VSangtani/crewline-roller-pcb/history/pcb-top.png

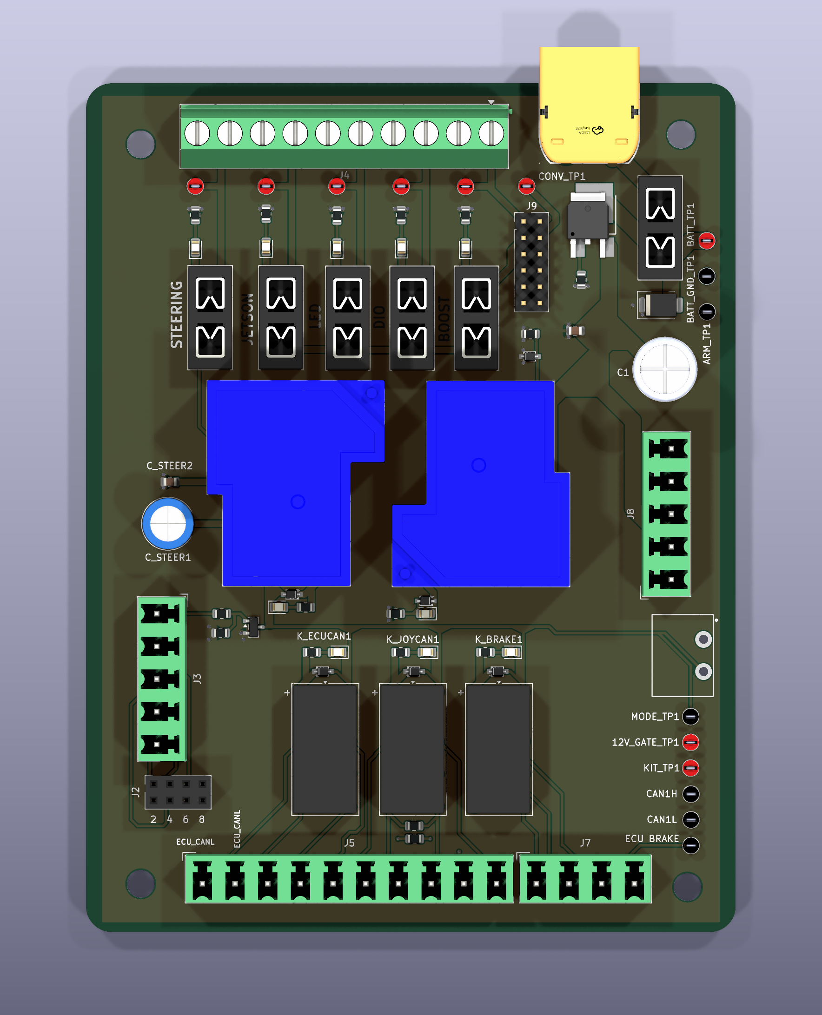
history/pcb-top.png
