VSangtani/crewline-roller-pcb/new/pcb-bottom.png

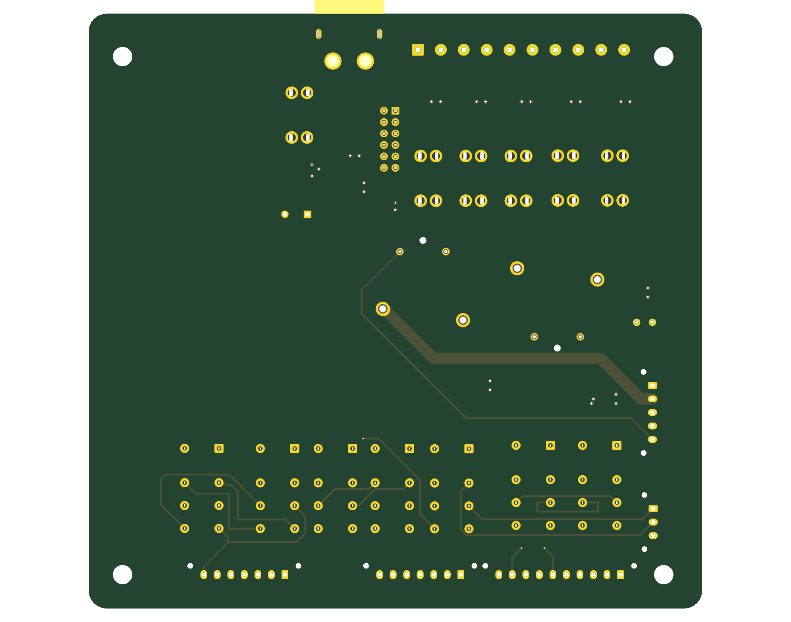
new/pcb-bottom.png
