VSangtani/crewline-roller-pcb/new/pcb-top.png

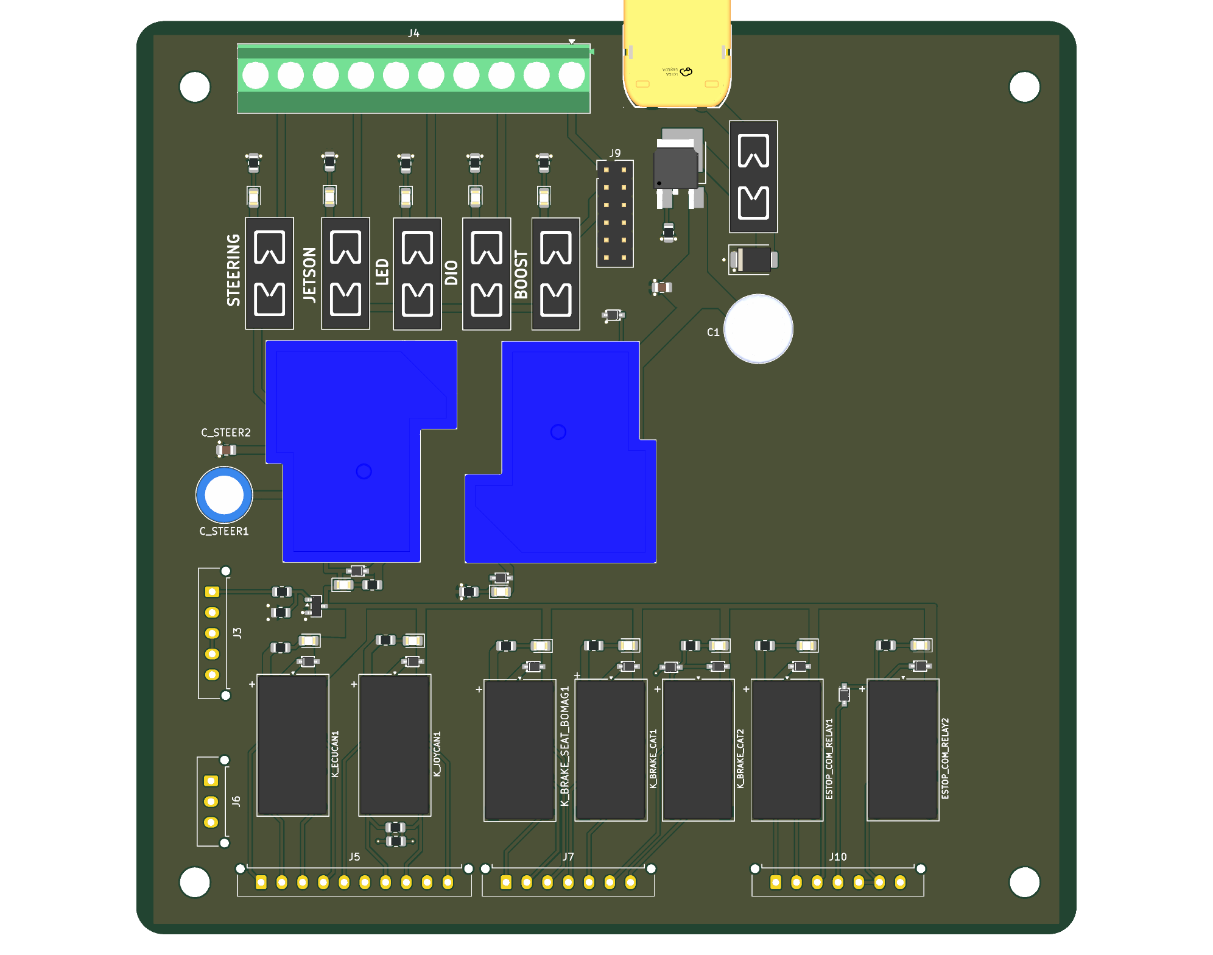
new/pcb-top.png
