VSangtani/crewline-roller-pcb/history/pcb.step

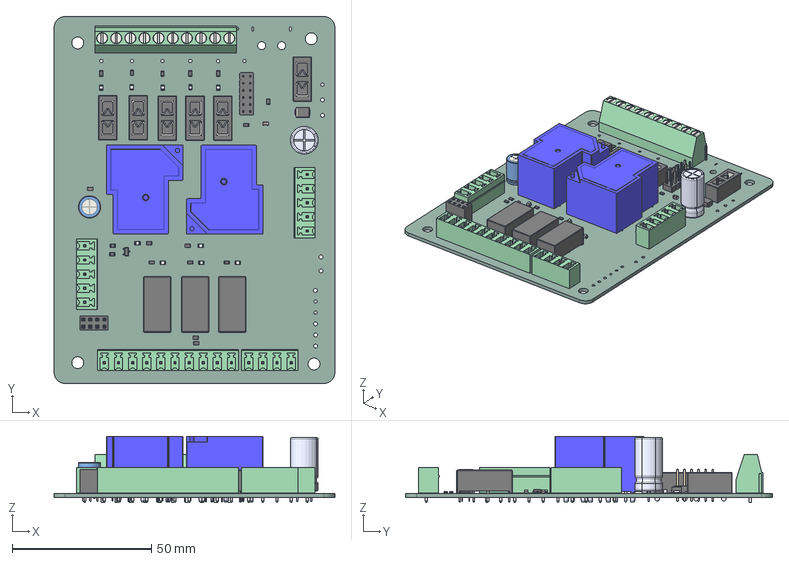
[picture p4: CAD file, 2026-09-28]
history/pcb.step
101.0 x 132.0 x 23.9 mm
PinSocket_2x04_P2.54mm_Vertical
TerminalBlock_Phoenix_MKDS-1,5-10-5.08_1x10_P5.08mm_Horizontal
R_0805_2012Metric x 16
LED_0805_2012Metric x 10
MCV_01x05_G_5_08mm x 2
A_Keystone_3568 x 6
PinHeader_2x06_P254mm_Vertical
SOT-23
MCV_01x04_G_5_08mm
SLA-12VDC-SL-C_SLA-12VDC-SL-C x 2
Relay_DPDT_Omron_G6A x 3
MCV_01x10_G_5_08mm
D_SMB
C_Radial_D80mm_H115mm_P350mm
C1_1000uF_leads_trimmed_to_3mm_for_assembly
C_0805_2012Metric x 2
CREWLINE-PRIM-PCB-001_PCB
