VSangtani/crewline-roller-pcb/new/pcb.step

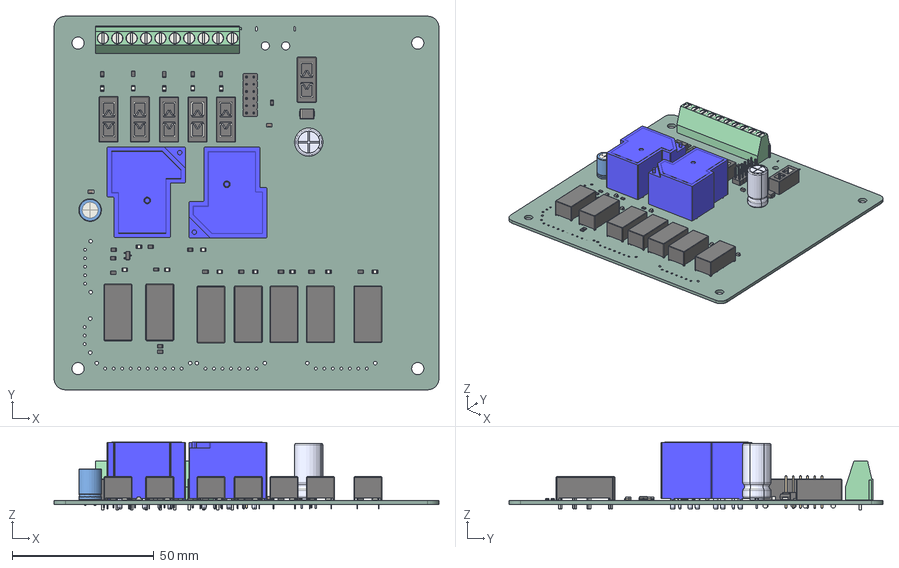
[picture p5: CAD file, 2026-10-01]
new/pcb.step
136.0 x 132.0 x 23.9 mm
LED_0805_2012Metric x 14
TerminalBlock_Phoenix_MKDS-1,5-10-5.08_1x10_P5.08mm_Horizontal
R_0805_2012Metric x 19
A_Keystone_3568 x 6
PinHeader_2x06_P254mm_Vertical
SOT-23
Relay_DPDT_Omron_G6A x 7
SLA-12VDC-SL-C_SLA-12VDC-SL-C x 2
D_SMB
C_Radial_D80mm_H115mm_P350mm
C1_1000uF_leads_trimmed_to_3mm_for_assembly
C_0805_2012Metric x 2
CREWLINE-PRIM-PCB-001_PCB
