VSangtani/crewline-roller-pcb/history/pcb_mated.step

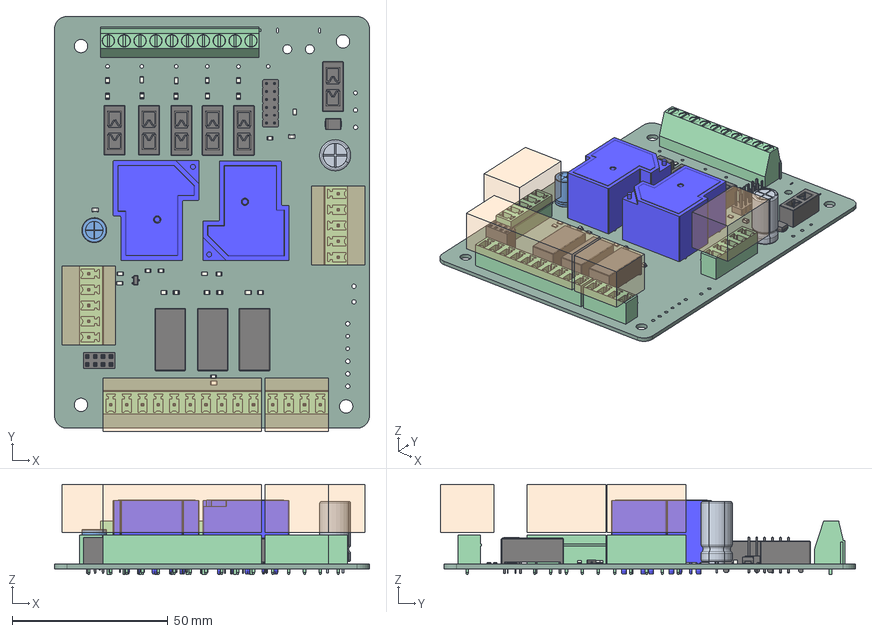
[picture p6: CAD file, 2026-09-28]
history/pcb_mated.step
101.0 x 133.1 x 29.0 mm
PinSocket_2x04_P2_54mm_Vertical
TerminalBlock_Phoenix_MKDS-1,5-10-5_08_1x10_P5_08mm_Horizontal
R_0805_2012Metric x 16
LED_0805_2012Metric x 10
MCV_01x05_G_5_08mm x 2
A_Keystone_3568 x 6
PinHeader_2x06_P254mm_Vertical
SOT-23
MCV_01x04_G_5_08mm
SLA-12VDC-SL-C_SLA-12VDC-SL-C x 2
Relay_DPDT_Omron_G6A x 3
MCV_01x10_G_5_08mm
D_SMB
C_Radial_D80mm_H115mm_P350mm
C1_1000uF_leads_trimmed_to_3mm_for_assembly
C_0805_2012Metric x 2
CREWLINE-PRIM-PCB-001_PCB
J3_plug_1836105_conservative_envelope
J5_plug_1836150_conservative_envelope
J7_plug_1836095_conservative_envelope
J8_plug_1836105_conservative_envelope
