VSangtani/crewline-roller-pcb/history/ABOUT.md

# Previous revision

These files describe the V3.1-H1 connector revision as it was before the brake and E-stop work.
They are kept for reference and are not maintained.

- `README.md` is that revision's own README.
- `original-design/` holds the three KiCad files and the footprint table exactly as they were
  in the first commit of this repository. Their 3D models are the ones in `../new/models/`.
- The reports, renders, scripts and STEP models are the outputs of that revision.

The live project is in `../new/`.
