VSangtani/crewline-roller-pcb/history/pcb-mated-check_20260925T151946Z.png

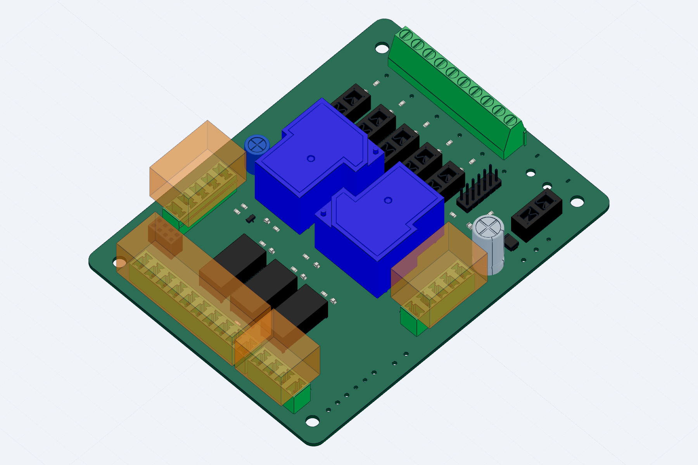
history/pcb-mated-check_20260925T151946Z.png
