VSangtani/crewline-roller-pcb/new/schematic.pdf

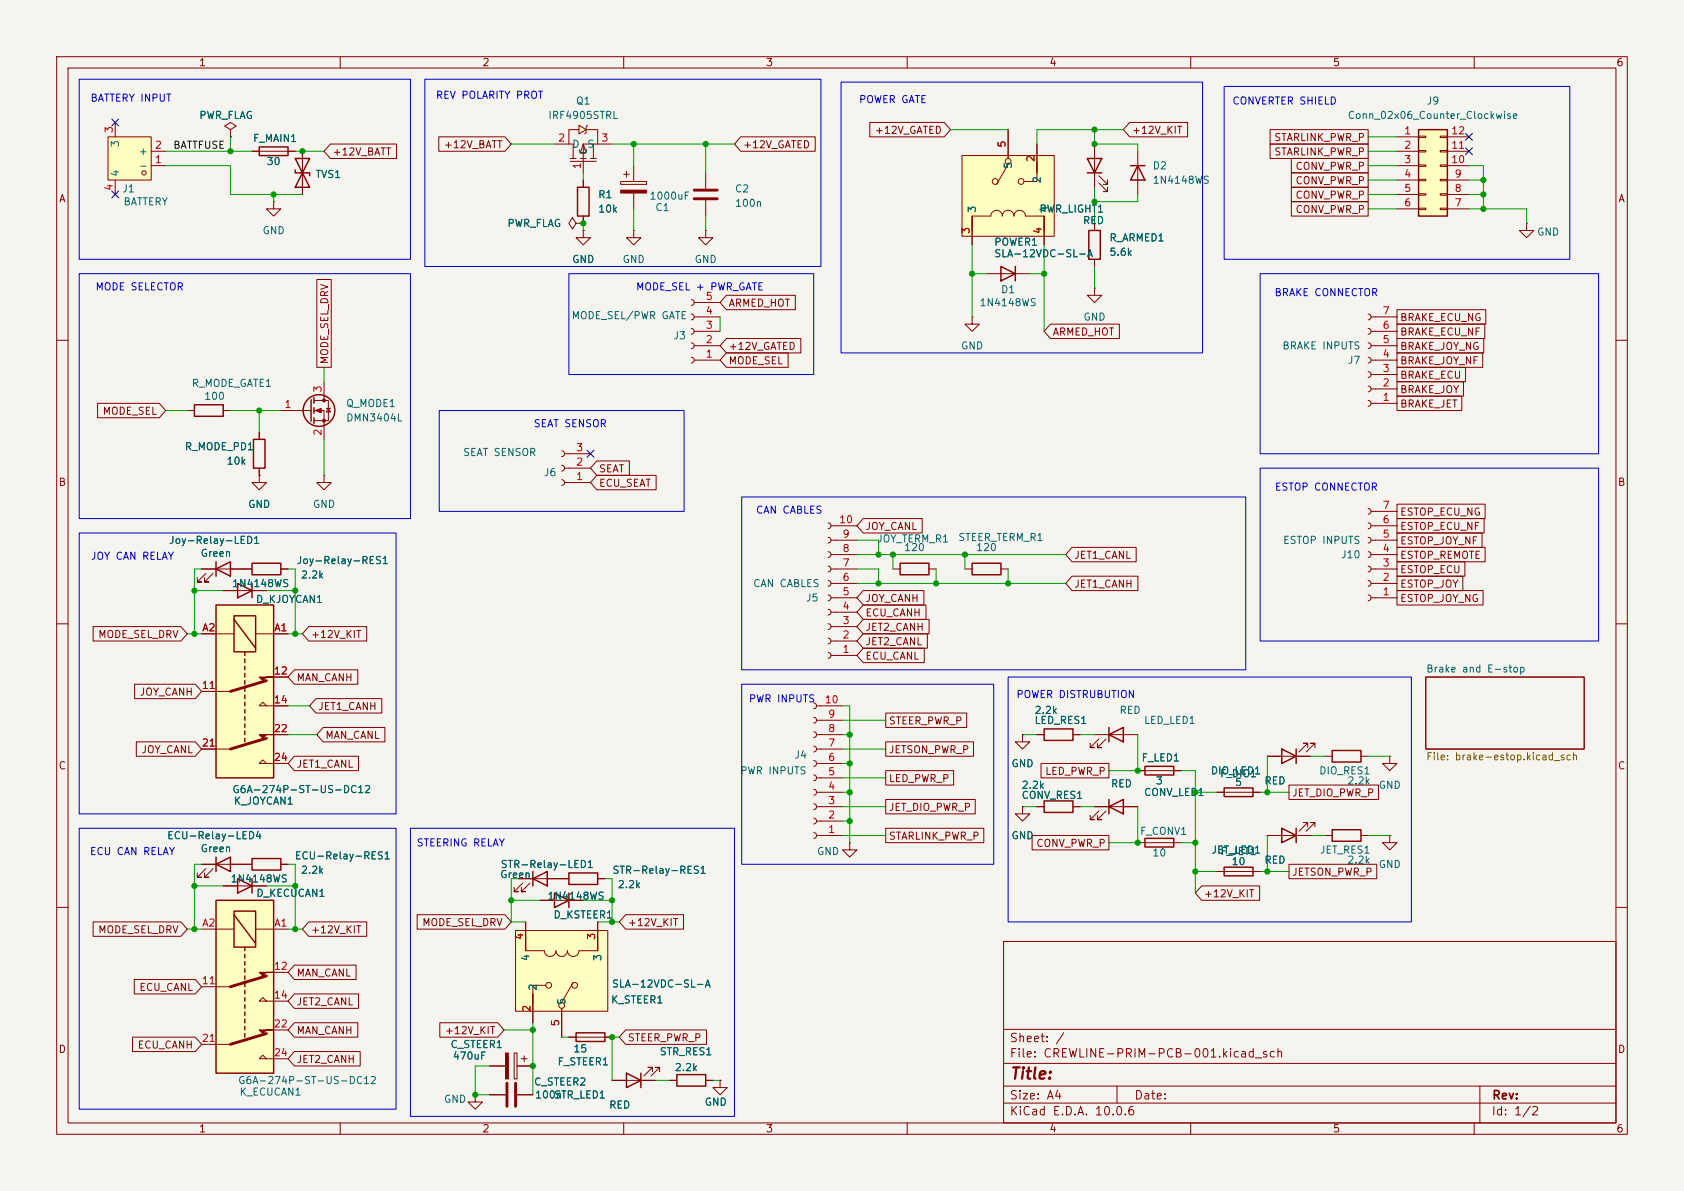
[picture p8: page 1]

File: brake-estop.kicad_sch GND

Joy-Relay-LED1 Green K_JOYCAN1 G6A-274P-ST-US-DC12

Sheet: /
File: CREWLINE-PRIM-PCB-001.kicad_sch
Title:

Size: A4 | Rev:
KiCad E.D.A. 10.0.6 | Id: 1/2

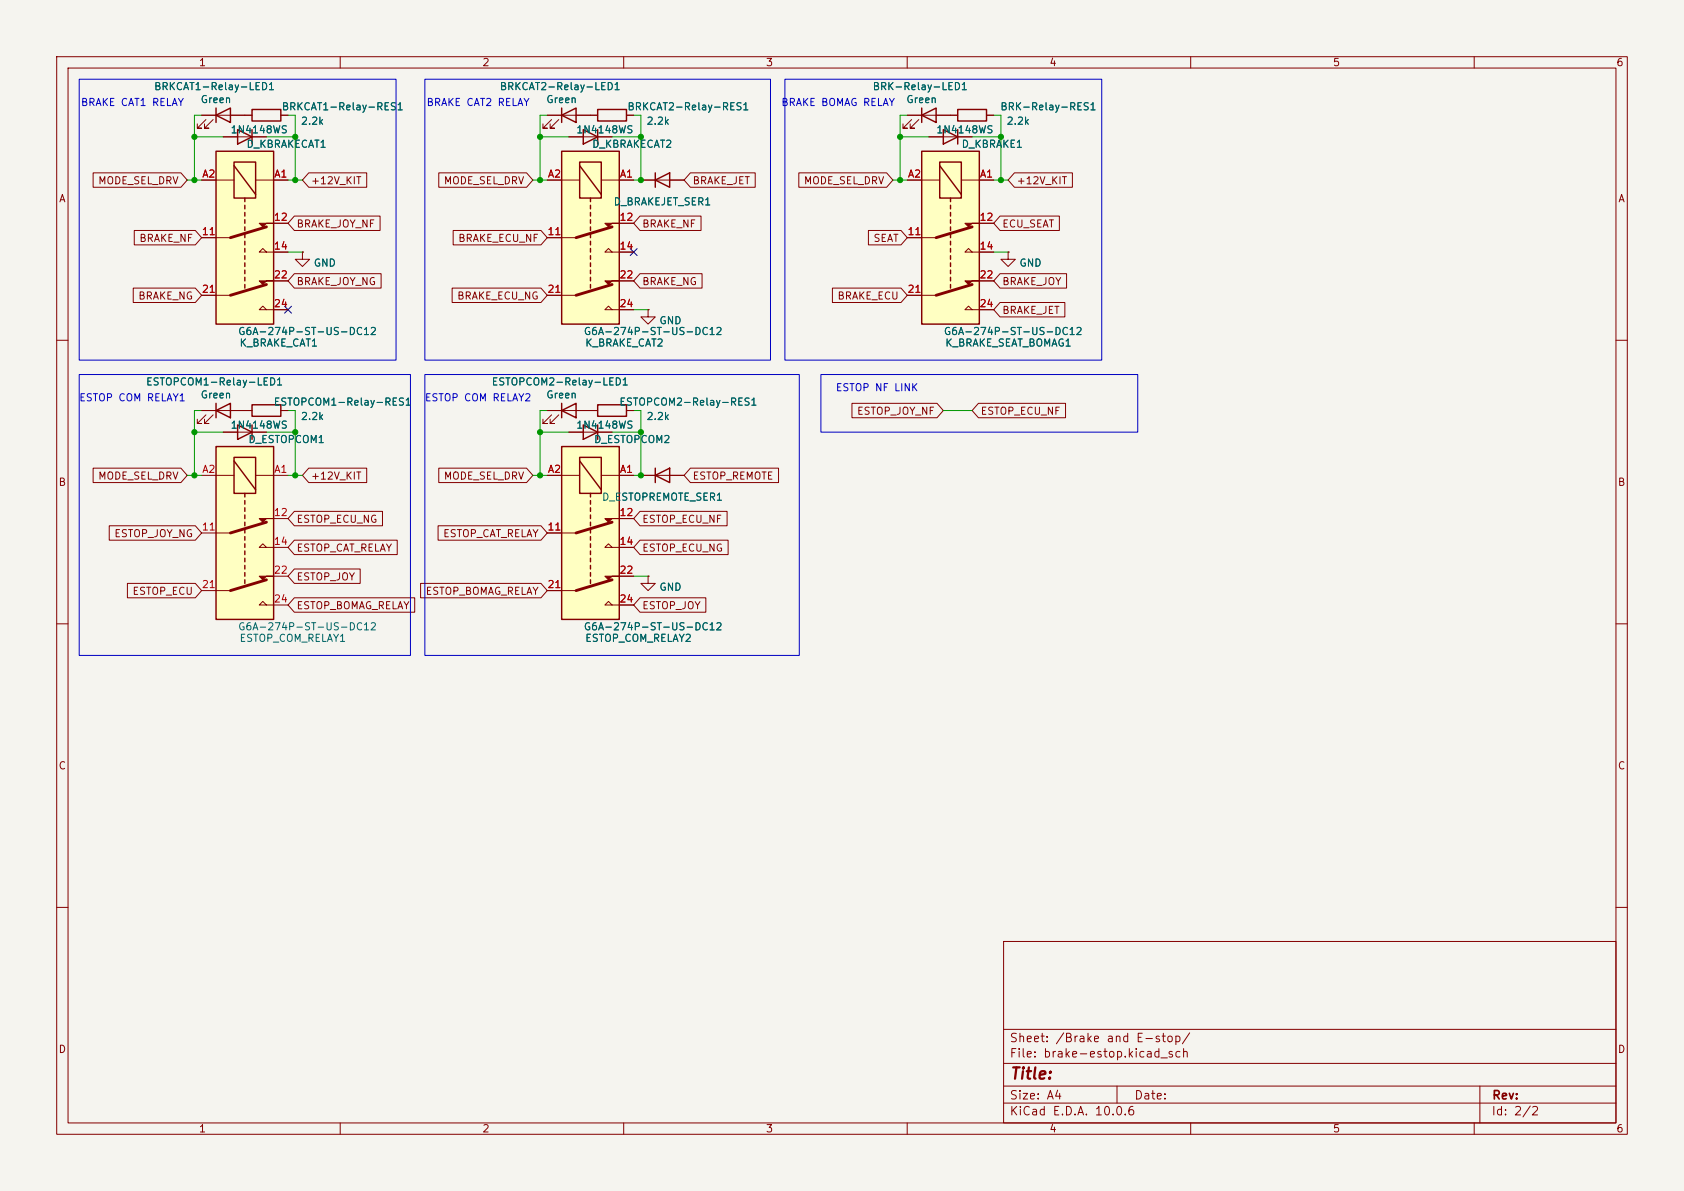
[picture p9: page 2]

1N4148WS BRKCAT1-Relay-LED1 Green K_BRAKE_CAT1 G6A-274P-ST-US-DC12

Sheet: /Brake and E-stop/
File: brake-estop.kicad_sch
Title:

Size: A4 | Rev:
KiCad E.D.A. 10.0.6 | Id: 2/2
