VSangtani/crewline-roller-pcb/history/schematic.pdf

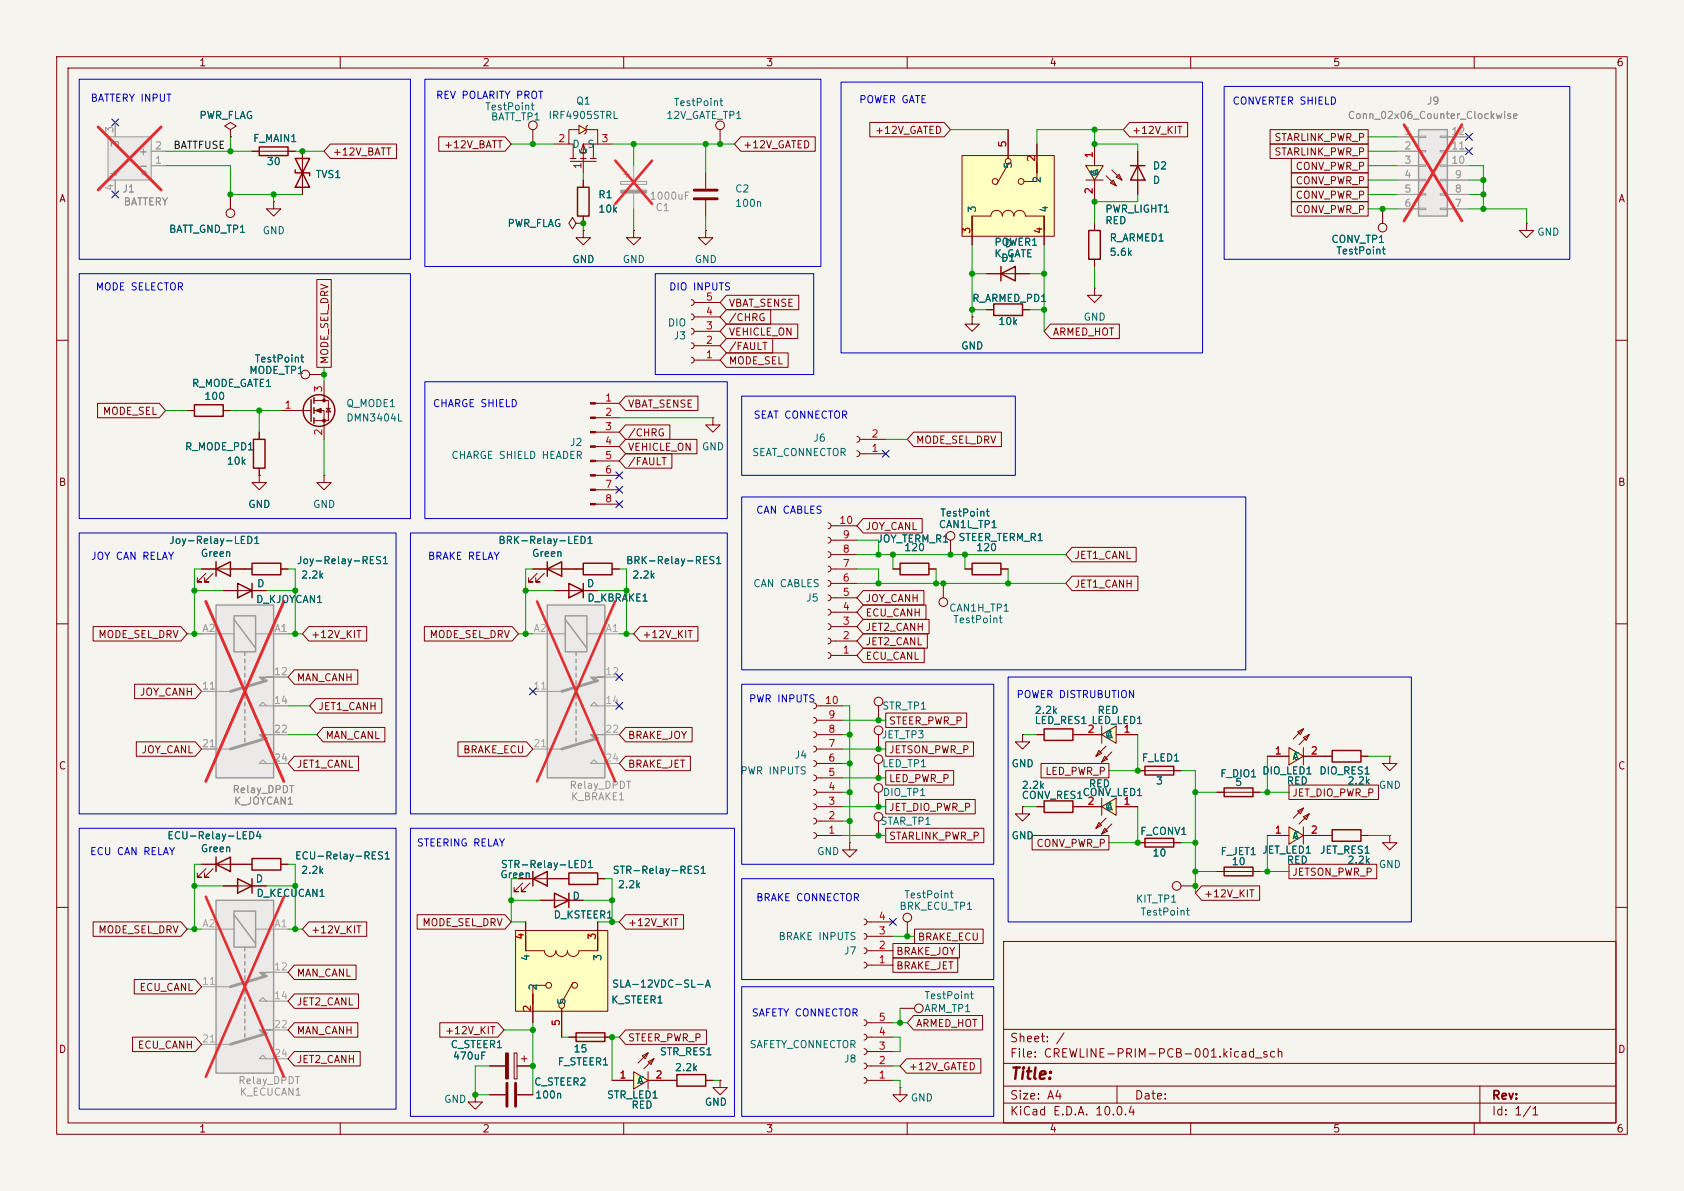
[picture p10: page 1]

REV POLARITY PROT CHARGE SHIELD

SLA-12VDC-SL-A STR-Relay-RES1

4 J8 2 | GND

Sheet: /
File: CREWLINE-PRIM-PCB-001.kicad_sch
Title:

Size: A4 | Rev:
KiCad E.D.A. 10.0.4 | Id: 1/1
