VSangtani/crewline-roller-pcb/new/_restore_backup_2026-09-30T12-59-34-863/CREWLINE-PRIM-PCB-001.kicad_pcb

## KiCad design new/_restore_backup_2026-09-30T12-59-34-863/CREWLINE-PRIM-PCB-001.kicad_pcb (2026-10-01)

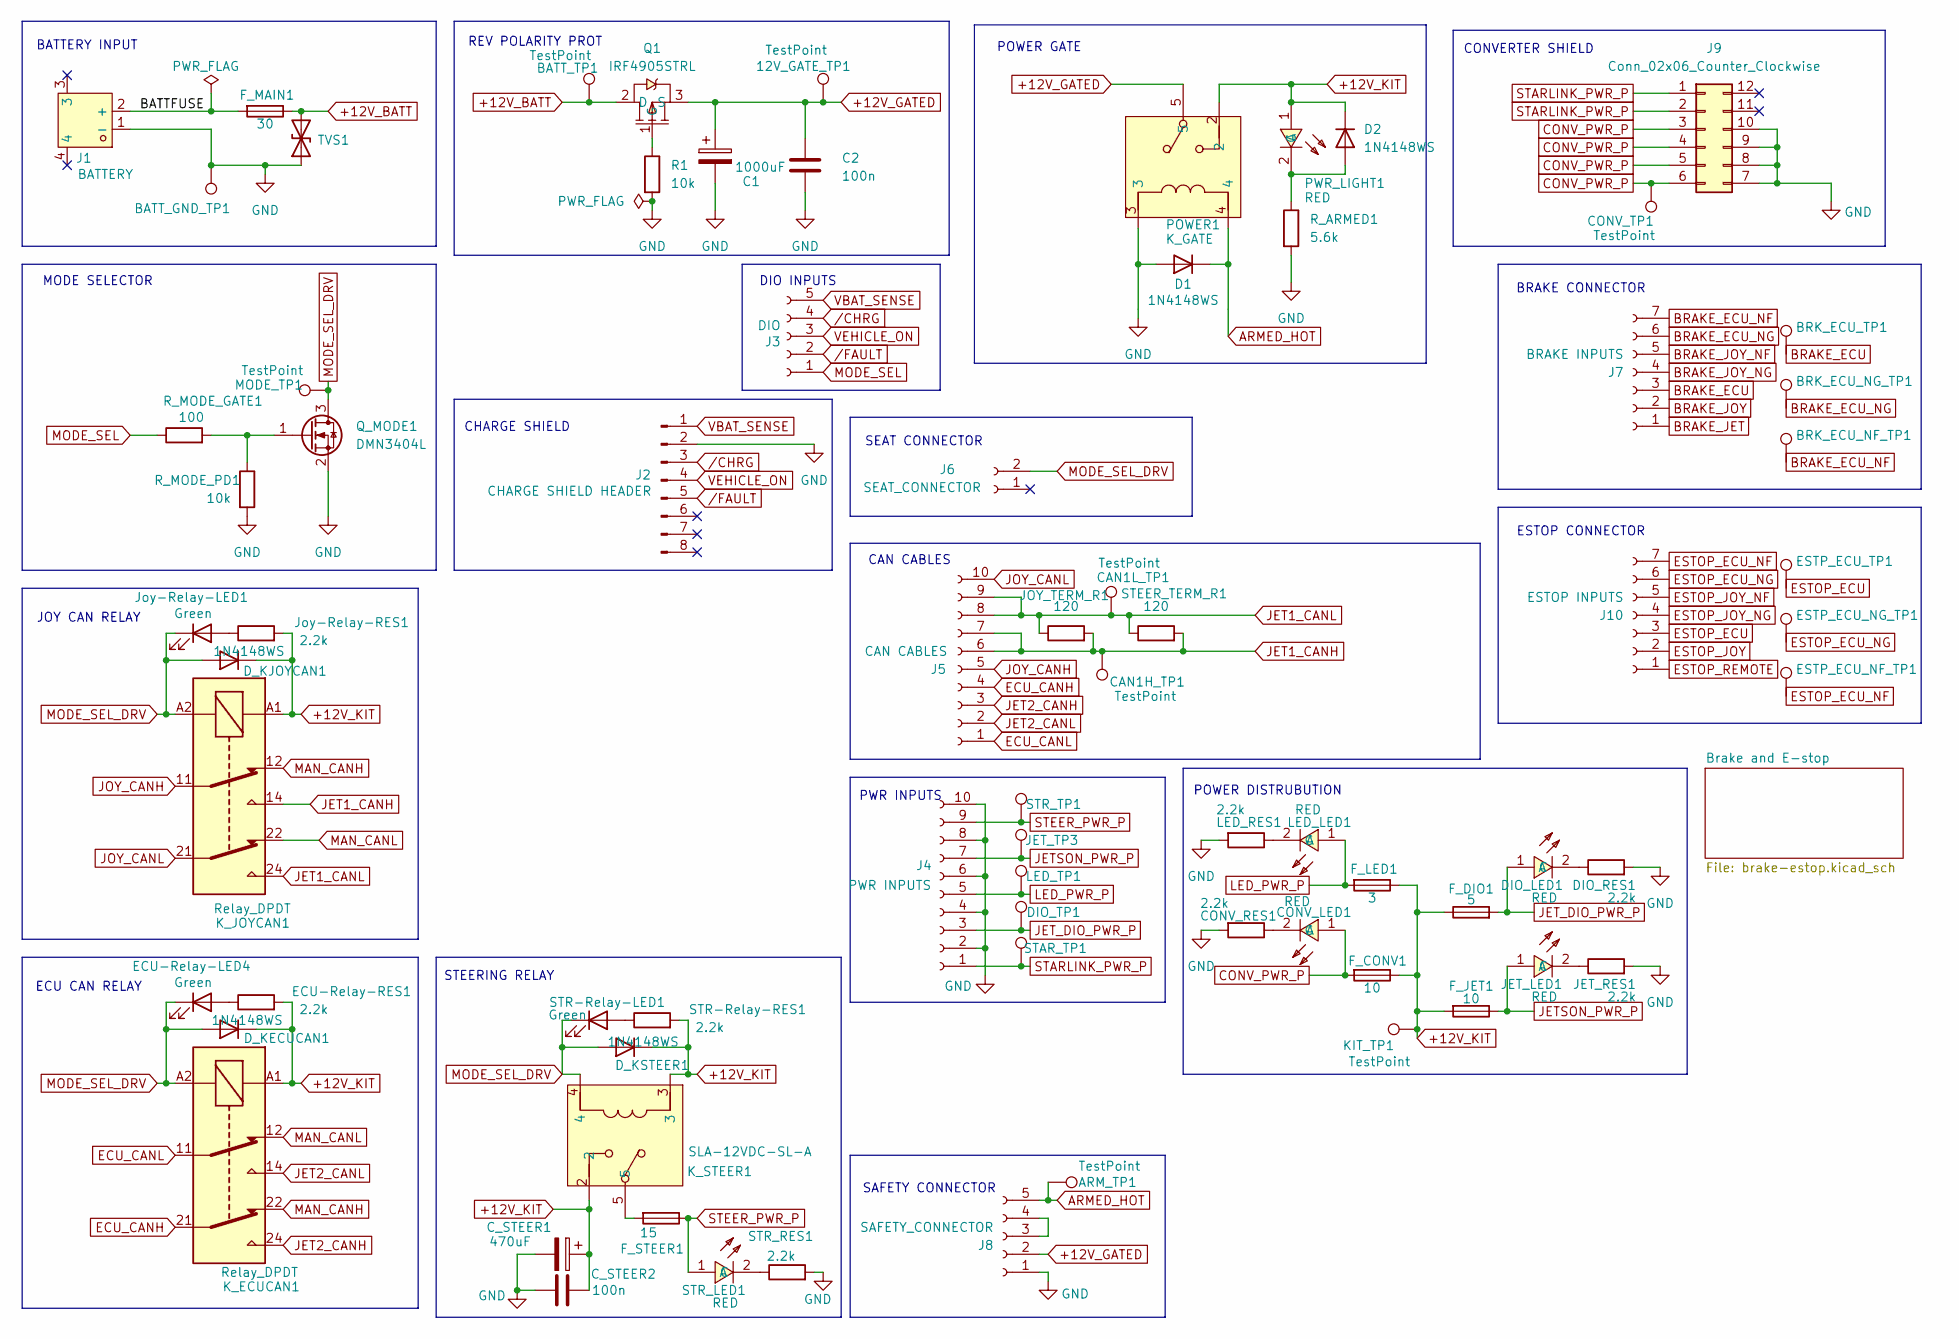
[picture p11: schematic CREWLINE-PRIM-PCB-001.kicad_sch]

Parts:
12V_GATE_TP1: TestPoint; TEST-TH_BD2.54-P1.4_RED; LCSC Part C5277086
ARM_TP1: TestPoint; TEST-TH_BD2.54-P1.4_BLACK; LCSC Part C5199801
BATT_GND_TP1: TestPoint; TEST-TH_BD2.54-P1.4_BLACK; LCSC Part C5199801
BATT_TP1: TestPoint; TEST-TH_BD2.54-P1.4_RED; LCSC Part C5277086
BRK_ECU_NF_TP1: TestPoint; TEST-TH_BD2.54-P1.4_BLACK; LCSC Part C5199801
BRK_ECU_NG_TP1: TestPoint; TEST-TH_BD2.54-P1.4_BLACK; LCSC Part C5199801
BRK_ECU_TP1: TestPoint; TEST-TH_BD2.54-P1.4_BLACK; LCSC Part C5199801
C1: 1000uF; ECA1EM102; LCSC Part C44650
C2: 100n; C_0805_2012Metric; LCSC Part C49678
CAN1H_TP1, CAN1L_TP1: TestPoint; TEST-TH_BD2.54-P1.4_BLACK; LCSC Part C5199801
CONV_LED1: RED; LED_0805_2012Metric
CONV_RES1: 2.2k; R_0805_2012Metric; LCSC Part C25879
CONV_TP1: TestPoint; TEST-TH_BD2.54-P1.4_RED; LCSC Part C5277086
C_STEER1: 470uF; C_Radial_D8.0mm_H11.5mm_P3.50mm; LCSC Part C44897
C_STEER2: 100n; C_0805_2012Metric; LCSC Part C49678
D1, D2: 1N4148WS; SOD-323_L1.8-W1.3-LS2.5-RD; LCSC Part C81598
DIO_LED1: RED; LED_0805_2012Metric
DIO_RES1: 2.2k; R_0805_2012Metric; LCSC Part C25879
DIO_TP1: TestPoint; TEST-TH_BD2.54-P1.4_RED; LCSC Part C5277086
D_KECUCAN1: 1N4148WS; SOD-323_L1.8-W1.3-LS2.5-RD; LCSC Part C81598
D_KJOYCAN1: 1N4148WS; SOD-323_L1.8-W1.3-LS2.5-RD; LCSC Part C81598
D_KSTEER1: 1N4148WS; SOD-323_L1.8-W1.3-LS2.5-RD; LCSC Part C81598
ECU-Relay-LED4: Green; LED_0805_2012Metric; LCSC Part C72043
ECU-Relay-RES1: 2.2k; R_0805_2012Metric; LCSC Part C25879
ESTP_ECU_NF_TP1: TestPoint; TEST-TH_BD2.54-P1.4_BLACK; LCSC Part C5199801
ESTP_ECU_NG_TP1: TestPoint; TEST-TH_BD2.54-P1.4_BLACK; LCSC Part C5199801
ESTP_ECU_TP1: TestPoint; TEST-TH_BD2.54-P1.4_BLACK; LCSC Part C5199801
F_CONV1: 10; Fuseholder_Blade_Mini_Keystone_3568; LCSC Part DNP
F_DIO1: 5; Fuseholder_Blade_Mini_Keystone_3568; LCSC Part DNP
F_JET1: 10; Fuseholder_Blade_Mini_Keystone_3568; LCSC Part DNP
F_LED1: 3; Fuseholder_Blade_Mini_Keystone_3568; LCSC Part DNP
F_MAIN1: 30; Fuseholder_Blade_Mini_Keystone_3568; MPN 0297030.U; LCSC Part DNP
F_STEER1: 15; Fuseholder_Blade_Mini_Keystone_3568; LCSC Part DNP
J1: BATTERY; CONN-TH_XT60PW-M; MPN XT60PW-M; LCSC Part C98732
J2: CHARGE SHIELD HEADER; PinSocket_2x04_P2.54mm_Vertical; LCSC Part DNP
J3: DIO; MCV_1.5_5_5.08_Pad2.6; MPN 1836325
J4: PWR INPUTS; TerminalBlock_Phoenix_MKDS-1,5-10-5.08_1x10_P5.08mm_Horizon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; LCSC Part DNP
J5: CAN CABLES; MCV_1.5_10_5.08_Pad2.6; MPN 1836370
J6: SEAT_CONNECTOR; WAGO_2604-1102; LCSC Part DNP
J7: BRAKE INPUTS; MCV_1.5_7_5.08_Pad2.6; MPN 1836341
J8: SAFETY_CONNECTOR; MCV_1.5_5_5.08_Pad2.6; MPN 1836325
J9: Conn_02x06_Counter_Clockwise; PinHeader_2x06_P2.54mm_Vertical; LCSC Part C124388
J10: ESTOP INPUTS; MCV_1.5_7_5.08_Pad2.6; MPN 1836341
JET_LED1: RED; LED_0805_2012Metric
JET_RES1: 2.2k; R_0805_2012Metric; LCSC Part C25879
JET_TP3: TestPoint; TEST-TH_BD2.54-P1.4_RED; LCSC Part C5277086
JOY_TERM_R1: 120; R_0805_2012Metric; LCSC Part C22787
Joy-Relay-LED1: Green; LED_0805_2012Metric; LCSC Part C72043
Joy-Relay-RES1: 2.2k; R_0805_2012Metric; LCSC Part C25879
KIT_TP1: TestPoint; TEST-TH_BD2.54-P1.4_RED; LCSC Part C5277086
K_ECUCAN1: Relay_DPDT; Relay_DPDT_Omron_G6A; LCSC Part C45404
K_JOYCAN1: Relay_DPDT; Relay_DPDT_Omron_G6A; LCSC Part C45404
K_STEER1: SLA-12VDC-SL-A; RELAY-TH_SLA-XXVDC-XL-A; MPN SLA-12VDC-SL-A; LCSC Part C55194
LED_LED1: RED; LED_0805_2012Metric
LED_RES1: 2.2k; R_0805_2012Metric; LCSC Part C25879
LED_TP1: TestPoint; TEST-TH_BD2.54-P1.4_RED; LCSC Part C5277086
MODE_TP1: TestPoint; TEST-TH_BD2.54-P1.4_BLACK; LCSC Part C5199801
POWER1: K_GATE; RELAY-TH_SLA-XXVDC-XL-A; MPN SLA-12VDC-SL-A; LCSC Part C55194
PWR_LIGHT1: RED; LED_0805_2012Metric
Q1: IRF4905STRL; TO-252-2_L6.6-W6.1-P4.57-LS10.1-BR-CW; MPN IRF4905STRL(UMW); LCSC Part C7471852
Q_MODE1: DMN3404L; SOT-23; LCSC Part C700958
R1: 10k; R_0805_2012Metric; LCSC Part C17414
R_ARMED1: 5.6k; R_0805_2012Metric; LCSC Part C17475
R_MODE_GATE1: 100; R_0805_2012Metric; LCSC Part C17561
R_MODE_PD1: 10k; R_0805_2012Metric; LCSC Part C17414
STAR_TP1: TestPoint; TEST-TH_BD2.54-P1.4_RED; LCSC Part C5277086
STEER_TERM_R1: 120; R_0805_2012Metric; LCSC Part C22787
STR-Relay-LED1: Green; LED_0805_2012Metric; LCSC Part C72043
STR-Relay-RES1: 2.2k; R_0805_2012Metric; LCSC Part C25879
STR_LED1: RED; LED_0805_2012Metric
STR_RES1: 2.2k; R_0805_2012Metric; LCSC Part C25879
STR_TP1: TestPoint; TEST-TH_BD2.54-P1.4_RED; LCSC Part C5277086
TVS1: SMBJ24CA; D_SMB; MPN SMBJ24CA-13-F; LCSC Part C13616

Connections:
+12V_BATT: BATT_TP1.1 (1_1), F_MAIN1.1, Q1.2 (D), TVS1.2 (A2)
+12V_GATED: 12V_GATE_TP1.1 (1_1), C1.1, C2.1, J8.2, POWER1.5, Q1.3 (S)
+12V_KIT: C_STEER1.1, C_STEER2.2, D2.1 (K), D_KECUCAN1.1 (K), D_KJOYCAN1.1 (K), D_KSTEER1.1 (K), ECU-Relay-RES1.2, F_CONV1.1, F_DIO1.1, F_JET1.2, F_LED1.1, Joy-Relay-RES1.2, KIT_TP1.1 (1_1), K_ECUCAN1.A1, K_JOYCAN1.A1, K_STEER1.2, K_STEER1.3, POWER1.2, PWR_LIGHT1.1 (A), STR-Relay-RES1.2; also elsewhere on the board
/BATTFUSE: F_MAIN1.2, J1.2 (+)
ARMED_HOT: ARM_TP1.1 (1_1), D1.1 (K), J8.5, POWER1.4
BRAKE_ECU: BRK_ECU_TP1.1 (1_1), J7.3; also elsewhere on the board
BRAKE_ECU_NF: BRK_ECU_NF_TP1.1 (1_1), J7.7; also elsewhere on the board
BRAKE_ECU_NG: BRK_ECU_NG_TP1.1 (1_1), J7.6; also elsewhere on the board
BRAKE_JET: J7.1; also elsewhere on the board
BRAKE_JOY: J7.2; also elsewhere on the board
BRAKE_JOY_NF: J7.5; also elsewhere on the board
BRAKE_JOY_NG: J7.4; also elsewhere on the board
CONV_PWR_P: CONV_LED1.1 (A), CONV_TP1.1 (1_1), F_CONV1.2, J9.3, J9.4, J9.5, J9.6
ECU_CANH: J5.4, K_ECUCAN1.21
ECU_CANL: J5.1, K_ECUCAN1.11
ESTOP_ECU: ESTP_ECU_TP1.1 (1_1), J10.3; also elsewhere on the board
ESTOP_ECU_NF: ESTP_ECU_NF_TP1.1 (1_1), J10.5, J10.7; also elsewhere on the board
ESTOP_ECU_NG: ESTP_ECU_NG_TP1.1 (1_1), J10.6; also elsewhere on the board
ESTOP_JOY: J10.2; also elsewhere on the board
ESTOP_JOY_NG: J10.4; also elsewhere on the board
ESTOP_REMOTE: J10.1; also elsewhere on the board
GND: BATT_GND_TP1.1 (1_1), C1.2, C2.2, CONV_RES1.2, C_STEER1.2, C_STEER2.1, D1.2 (A), DIO_RES1.2, J1.1 (-), J2.2, J4.2, J4.4, J4.6, J4.8, J4.10, J8.1, J9.7, J9.8, J9.9, J9.10, JET_RES1.2, LED_RES1.2, POWER1.3, Q_MODE1.2 (S), R1.2, R_ARMED1.2, R_MODE_PD1.2, STR_RES1.2, TVS1.1 (A1); also elsewhere on the board
JET1_CANH: CAN1H_TP1.1 (1_1), J5.6, J5.7, JOY_TERM_R1.2, K_JOYCAN1.14, STEER_TERM_R1.2
JET1_CANL: CAN1L_TP1.1 (1_1), J5.8, J5.9, JOY_TERM_R1.1, K_JOYCAN1.24, STEER_TERM_R1.1
JET2_CANH: J5.3, K_ECUCAN1.24
JET2_CANL: J5.2, K_ECUCAN1.14
JETSON_PWR_P: F_JET1.1, J4.7, JET_LED1.1 (A), JET_TP3.1 (1_1)
JET_DIO_PWR_P: DIO_LED1.1 (A), DIO_TP1.1 (1_1), F_DIO1.2, J4.3
JOY_CANH: J5.5, K_JOYCAN1.11
JOY_CANL: J5.10, K_JOYCAN1.21
LED_PWR_P: F_LED1.2, J4.5, LED_LED1.1 (A), LED_TP1.1 (1_1)
MAN_CANH: K_ECUCAN1.22, K_JOYCAN1.12
MAN_CANL: K_ECUCAN1.12, K_JOYCAN1.22
MODE_SEL: J3.1, R_MODE_GATE1.1
MODE_SEL_DRV: D_KECUCAN1.2 (A), D_KJOYCAN1.2 (A), D_KSTEER1.2 (A), ECU-Relay-LED4.1 (K), J6.2 (Pin_2_2), Joy-Relay-LED1.1 (K), K_ECUCAN1.A2, K_JOYCAN1.A2, K_STEER1.4, MODE_TP1.1 (1_1), Q_MODE1.3 (D), STR-Relay-LED1.1 (K); also elsewhere on the board
unnamed: CONV_LED1.2 (C), CONV_RES1.1
unnamed: D2.2 (A), PWR_LIGHT1.2 (C), R_ARMED1.1
unnamed: DIO_LED1.2 (C), DIO_RES1.1
unnamed: ECU-Relay-LED4.2 (A), ECU-Relay-RES1.1
unnamed: F_STEER1.2, K_STEER1.5
unnamed: J8.3, J8.4
unnamed: JET_LED1.2 (C), JET_RES1.1
unnamed: Joy-Relay-LED1.2 (A), Joy-Relay-RES1.1
unnamed: LED_LED1.2 (C), LED_RES1.1
unnamed: Q1.1 (G), R1.1
unnamed: Q_MODE1.1 (G), R_MODE_GATE1.2, R_MODE_PD1.1
unnamed: STR-Relay-LED1.2 (A), STR-Relay-RES1.1
unnamed: STR_LED1.2 (C), STR_RES1.1
STARLINK_PWR_P: J4.1, J9.1, J9.2, STAR_TP1.1 (1_1)
STEER_PWR_P: F_STEER1.1, J4.9, STR_LED1.1 (A), STR_TP1.1 (1_1)
VBAT_SENSE: J2.1, J3.5
VEHICLE_ON: J2.4, J3.3
/CHRG: J2.3, J3.4
/FAULT: J2.5, J3.2

Notes on the sheet:
SAFETY CONNECTOR
CHARGE SHIELD
CONVERTER SHIELD
DIO INPUTS
STEERING RELAY
POWER GATE
SEAT CONNECTOR
MODE SELECTOR
POWER DISTRUBUTION
REV POLARITY PROT
ECU CAN RELAY
PWR INPUTS
BATTERY INPUT
JOY CAN RELAY
CAN CABLES
BRAKE CONNECTOR
ESTOP CONNECTOR

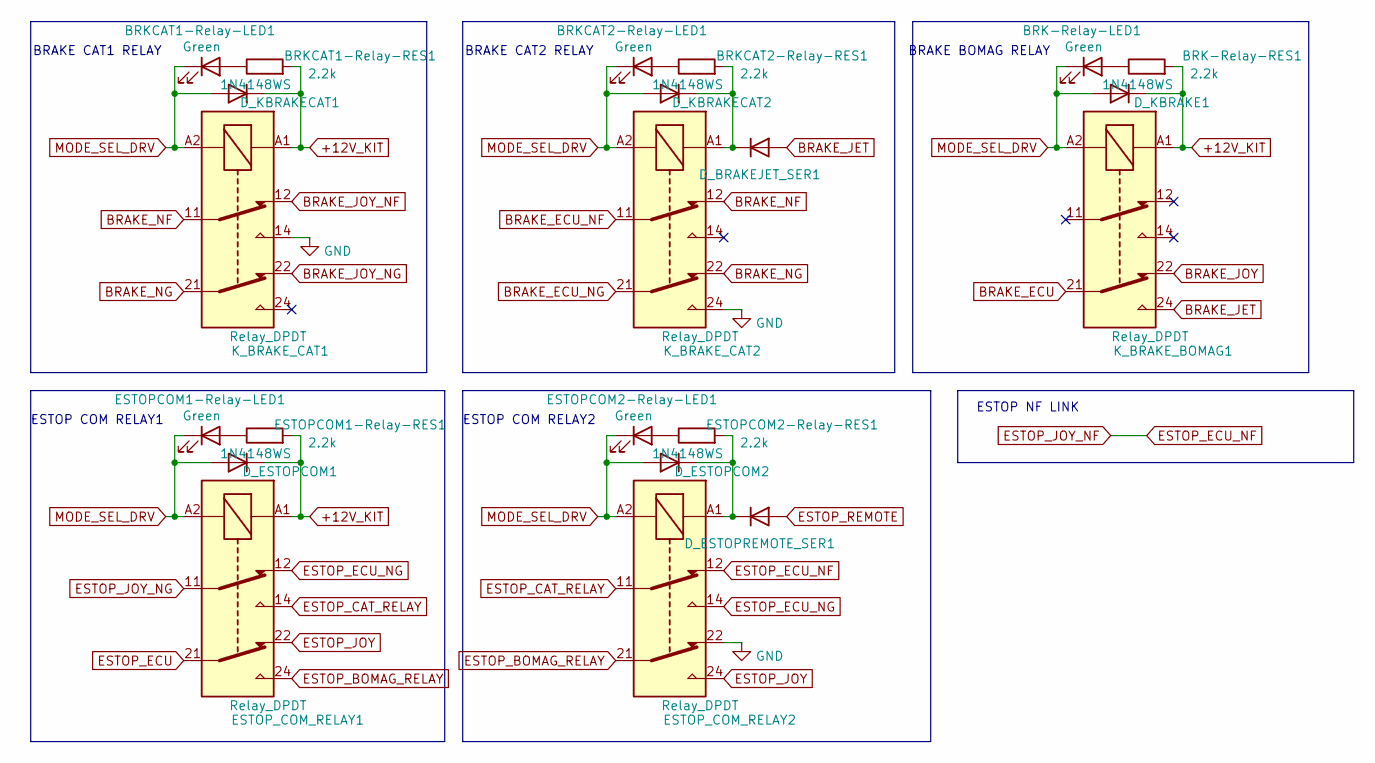
[picture p12: schematic brake-estop.kicad_sch]

Parts:
BRK-Relay-LED1: Green; LED_0805_2012Metric; LCSC Part C72043
BRK-Relay-RES1: 2.2k; R_0805_2012Metric; LCSC Part C25879
BRKCAT1-Relay-LED1, BRKCAT2-Relay-LED1: Green; LED_0805_2012Metric; LCSC Part C72043
BRKCAT1-Relay-RES1, BRKCAT2-Relay-RES1: 2.2k; R_0805_2012Metric; LCSC Part C25879
D_BRAKEJET_SER1: 1N4148WS; SOD-323_L1.8-W1.3-LS2.5-RD; LCSC Part C81598
D_ESTOPCOM1, D_ESTOPCOM2: 1N4148WS; SOD-323_L1.8-W1.3-LS2.5-RD; LCSC Part C81598
D_ESTOPREMOTE_SER1: 1N4148WS; SOD-323_L1.8-W1.3-LS2.5-RD; LCSC Part C81598
D_KBRAKE1: 1N4148WS; SOD-323_L1.8-W1.3-LS2.5-RD; LCSC Part C81598
D_KBRAKECAT1, D_KBRAKECAT2: 1N4148WS; SOD-323_L1.8-W1.3-LS2.5-RD; LCSC Part C81598
ESTOPCOM1-Relay-LED1, ESTOPCOM2-Relay-LED1: Green; LED_0805_2012Metric; LCSC Part C72043
ESTOPCOM1-Relay-RES1, ESTOPCOM2-Relay-RES1: 2.2k; R_0805_2012Metric; LCSC Part C25879
ESTOP_COM_RELAY1, ESTOP_COM_RELAY2: Relay_DPDT; Relay_DPDT_Omron_G6A; LCSC Part C45404
K_BRAKE_BOMAG1: Relay_DPDT; Relay_DPDT_Omron_G6A; LCSC Part C45404
K_BRAKE_CAT1, K_BRAKE_CAT2: Relay_DPDT; Relay_DPDT_Omron_G6A; LCSC Part C45404

Connections:
+12V_KIT: BRK-Relay-RES1.2, BRKCAT1-Relay-RES1.2, D_ESTOPCOM1.1 (K), D_KBRAKE1.1 (K), D_KBRAKECAT1.1 (K), ESTOPCOM1-Relay-RES1.2, ESTOP_COM_RELAY1.A1, K_BRAKE_BOMAG1.A1, K_BRAKE_CAT1.A1; also elsewhere on the board
BRAKE_ECU: K_BRAKE_BOMAG1.21; also elsewhere on the board
BRAKE_ECU_NF: K_BRAKE_CAT2.11; also elsewhere on the board
BRAKE_ECU_NG: K_BRAKE_CAT2.21; also elsewhere on the board
BRAKE_JET: D_BRAKEJET_SER1.2 (A), K_BRAKE_BOMAG1.24; also elsewhere on the board
BRAKE_JOY: K_BRAKE_BOMAG1.22; also elsewhere on the board
BRAKE_JOY_NF: K_BRAKE_CAT1.12; also elsewhere on the board
BRAKE_JOY_NG: K_BRAKE_CAT1.22; also elsewhere on the board
BRAKE_NF: K_BRAKE_CAT1.11, K_BRAKE_CAT2.12
BRAKE_NG: K_BRAKE_CAT1.21, K_BRAKE_CAT2.22
ESTOP_BOMAG_RELAY: ESTOP_COM_RELAY1.24, ESTOP_COM_RELAY2.21
ESTOP_CAT_RELAY: ESTOP_COM_RELAY1.14, ESTOP_COM_RELAY2.11
ESTOP_ECU: ESTOP_COM_RELAY1.21; also elsewhere on the board
ESTOP_ECU_NF: ESTOP_COM_RELAY2.12; also elsewhere on the board
ESTOP_ECU_NG: ESTOP_COM_RELAY1.12, ESTOP_COM_RELAY2.14; also elsewhere on the board
ESTOP_JOY: ESTOP_COM_RELAY1.22, ESTOP_COM_RELAY2.24; also elsewhere on the board
ESTOP_JOY_NG: ESTOP_COM_RELAY1.11; also elsewhere on the board
ESTOP_REMOTE: D_ESTOPREMOTE_SER1.2 (A); also elsewhere on the board
GND: ESTOP_COM_RELAY2.22, K_BRAKE_CAT1.14, K_BRAKE_CAT2.24; also elsewhere on the board
MODE_SEL_DRV: BRK-Relay-LED1.1 (K), BRKCAT1-Relay-LED1.1 (K), BRKCAT2-Relay-LED1.1 (K), D_ESTOPCOM1.2 (A), D_ESTOPCOM2.2 (A), D_KBRAKE1.2 (A), D_KBRAKECAT1.2 (A), D_KBRAKECAT2.2 (A), ESTOPCOM1-Relay-LED1.1 (K), ESTOPCOM2-Relay-LED1.1 (K), ESTOP_COM_RELAY1.A2, ESTOP_COM_RELAY2.A2, K_BRAKE_BOMAG1.A2, K_BRAKE_CAT1.A2, K_BRAKE_CAT2.A2; also elsewhere on the board
unnamed: BRK-Relay-LED1.2 (A), BRK-Relay-RES1.1
unnamed: BRKCAT1-Relay-LED1.2 (A), BRKCAT1-Relay-RES1.1
unnamed: BRKCAT2-Relay-LED1.2 (A), BRKCAT2-Relay-RES1.1
unnamed: BRKCAT2-Relay-RES1.2, D_BRAKEJET_SER1.1 (K), D_KBRAKECAT2.1 (K), K_BRAKE_CAT2.A1
unnamed: D_ESTOPCOM2.1 (K), D_ESTOPREMOTE_SER1.1 (K), ESTOPCOM2-Relay-RES1.2, ESTOP_COM_RELAY2.A1
unnamed: ESTOPCOM1-Relay-LED1.2 (A), ESTOPCOM1-Relay-RES1.1
unnamed: ESTOPCOM2-Relay-LED1.2 (A), ESTOPCOM2-Relay-RES1.1

Notes on the sheet:
BRAKE CAT1 RELAY
BRAKE CAT2 RELAY
BRAKE BOMAG RELAY
ESTOP COM RELAY1
ESTOP COM RELAY2
ESTOP NF LINK

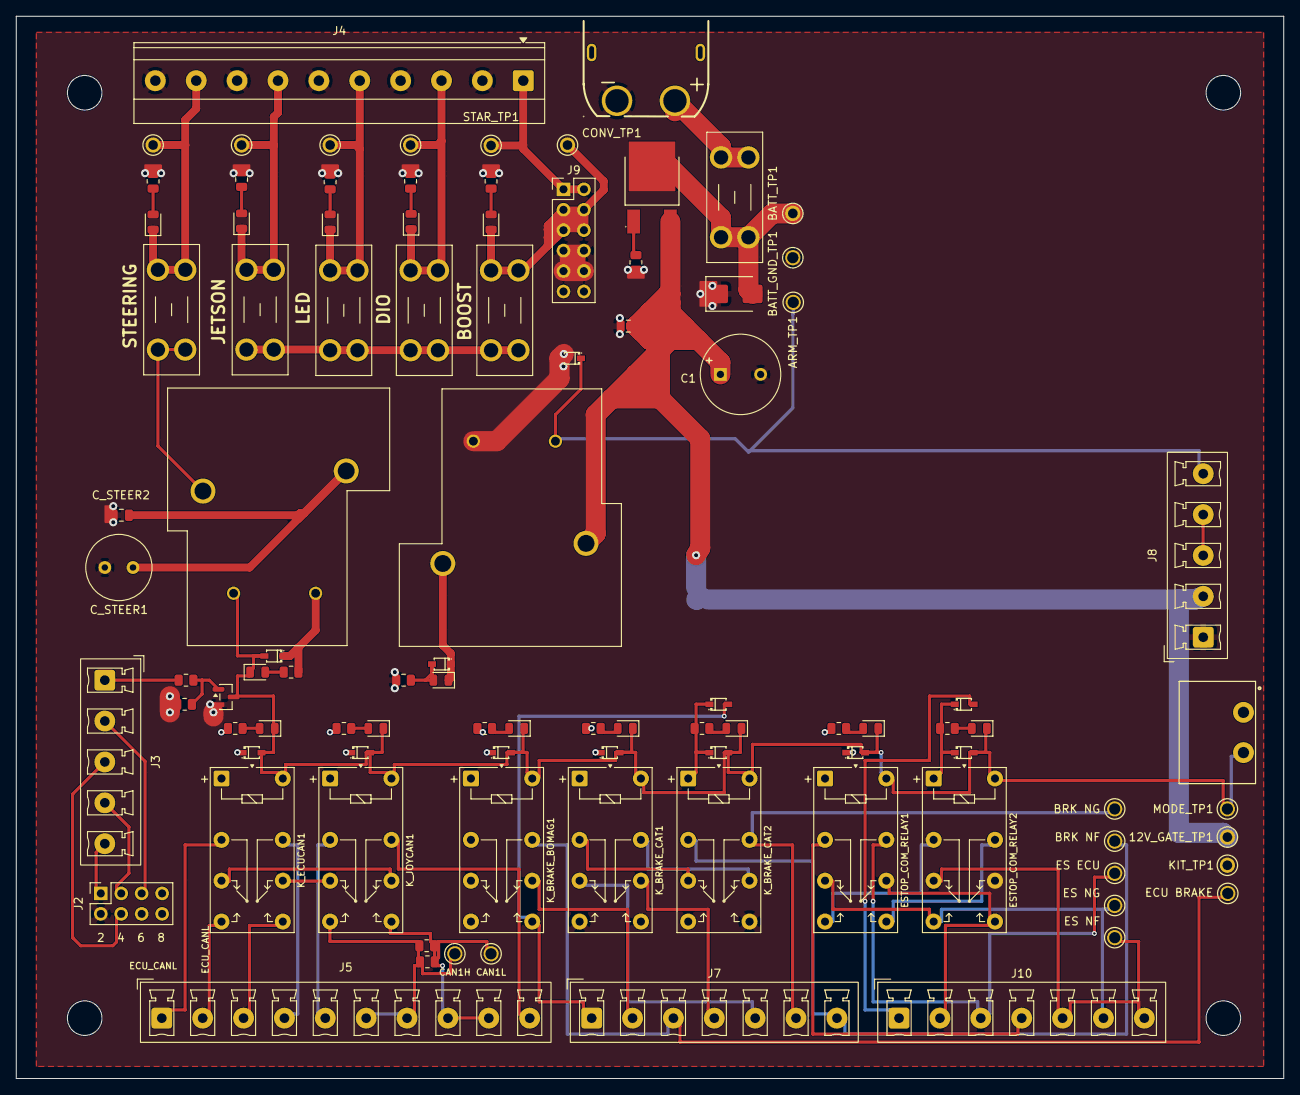
[picture p13: board CREWLINE-PRIM-PCB-001.kicad_pcb from above]

Board: 4 copper layers, 157.5 x 132.0 mm, 101 parts (0 on the bottom side), 65 nets.

Other parts of the board:
H1, H2, H3, H4: MountingHole_4.3mm_M4
