VSangtani/crewline-roller-pcb/(commit log)

2026-09-28 Add brake and E-stop relay logic to the schematic
    Extend J7 to 7 positions and add J10 for the E-stop lines. Add the
    child sheet brake-estop.kicad_sch with K_BRAKE_CAT1/2, K_ESTOP_BOMAG1/2
    and K_ESTOP_CAT1/2, and move K_BRAKE_BOMAG1 onto it. Each coil that a
    Jetson output feeds has a series 1N4148WS diode.
    Add five signal test points. Clear the six stale DNP flags. Replace the
    3 mm LED symbols with the generic LED symbol so pin 1 is the cathode,
    which matches the 0805 footprint. Recover the custom symbol and
    footprint libraries into lib/ and register them in the project tables.
    Add a 7-way MCV 1.5 footprint with 2.6 mm pads.
    [CREWLINE-PRIM-PCB-001.kicad_sch, brake-estop.kicad_sch]
2026-09-28 Keep the red LED polarity as built
    The boards in service light with the anode on pad 1, so the LED symbol
    keeps pin 1 as the anode. The symbol moves to the project library as
    LED_Red_0805_A1 with the polarity written in its description, and the
    3 mm part number fields are removed.
    [CREWLINE-PRIM-PCB-001.kicad_sch]
2026-09-29 Merge the E-stop relays and rename ESTOP_JET to ESTOP_REMOTE
    The four E-stop relays become ESTOP_COM_RELAY1 and ESTOP_COM_RELAY2.
    Each keeps the coil of its BOMAG relay and takes the CAT contacts on
    its spare pole. The support parts follow the new names and the second
    series diode is removed.
    [CREWLINE-PRIM-PCB-001.kicad_sch, brake-estop.kicad_sch]
2026-09-29 Grow the board and route the new relay and connector circuits
    Widen the board by 56.5 mm so J5, J7 and J10 fit on the bottom edge.
    Move J8, J6, the test point column and the right-hand mounting holes
    with the edge. Place seven DPDT relays in one row above the connectors
    with their diodes, LEDs and resistors, and add the five new test points.
    Route all new connections on the outer layers with a grid router that
    keeps the clearance rules, the mounting hole washer areas and a 2 mm
    edge margin. The CAN pair runs side by side. DRC reports no errors,
    no warnings and no unconnected items.
    Trim the XT60 silkscreen at the board edge in the project library and
    move the J4 reference clear of its test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
    [CREWLINE-PRIM-PCB-001.kicad_pcb]
2026-09-29 Split the repository into history and new
    Move the previous revision's files and a copy of the original design
    into history/. Move the live project into new/ with its libraries,
    models and tools, and add the derived files: schematic PDF, renders,
    STEP model, BOM, netlist and rule check reports. Add a README for the
    new revision.
    [CREWLINE-PRIM-PCB-001.kicad_pcb, CREWLINE-PRIM-PCB-001.kicad_sch, bom-delta.csv, bom.csv, brake-estop.kicad_sch, pcb.step, pcb_mated.step, signal-pin-map.csv]
2026-09-29 Apply the routine findings of the independent review
    Via sizes now follow the net class, and +12V_GATED and +12V_KIT are
    re-routed with them. Relay references sit below the relay bodies with
    a 0.15 mm stroke. The mounting holes are H1 to H4, board-only, on a
    rectangular pattern. Diodes carry the value 1N4148WS. The README
    records the re-routed nets, the disabled checks and the open items.
    Derived files regenerated.
    [CREWLINE-PRIM-PCB-001.kicad_pcb, CREWLINE-PRIM-PCB-001.kicad_sch, bom.csv, brake-estop.kicad_sch, pcb.step]
2026-09-29 Move the CAN test points beside J5 and record the review outcomes
    CAN1H_TP1 and CAN1L_TP1 now sit above J5 pins 6 to 9 so their stubs on
    the bus are short, and the pair is routed together. Relay references
    stand in the gap beside each body. The README records the BRAKE_JET
    supply limit and the open questions for the original designer.
    [CREWLINE-PRIM-PCB-001.kicad_pcb, pcb.step]
2026-10-01 Swap the signal connectors to Molex Micro-Fit, audit the BOM, shrink the board
    J3, J5, J6, J7 and J10 are Molex Micro-Fit 3.0 single-row through-hole
    headers. J8, J2 and all test points are removed; the arming loop moves to
    J3 and J6 becomes the seat sensor connector. The red LEDs use the
    standard symbol so pad 1 is the cathode. D1 is turned round and
    R_ARMED_PD1 removed. Every part number was checked against the JLCPCB
    library and corrected; J4 and the fuse holders are marked customer
    fitted. The board shrinks to 136 x 132 mm with the mounting holes on a
    120 x 115 mm rectangle. Footprint fields are synced so the parity check
    is clean. Derived files regenerated and README rewritten.
    Co-Auth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
    [CREWLINE-PRIM-PCB-001.kicad_pcb, CREWLINE-PRIM-PCB-001.kicad_sch, bom.csv, brake-estop.kicad_sch, pcb.step]
2026-10-01 Add the manufacturing outputs for JLCPCB
    Gerber set with drill files, the assembly BOM and placement file in
    JLCPCB column order, and a README with the order settings and the
    polarised parts to check in the placement preview.
    [CREWLINE-PRIM-PCB-001-B_Cu.gbr, CREWLINE-PRIM-PCB-001-B_Mask.gbr, CREWLINE-PRIM-PCB-001-B_Paste.gbr, CREWLINE-PRIM-PCB-001-B_Silkscreen.gbr, CREWLINE-PRIM-PCB-001-Edge_Cuts.gbr, CREWLINE-PRIM-PCB-001-F_Cu.gbr, CREWLINE-PRIM-PCB-001-F_Mask.gbr, CREWLINE-PRIM-PCB-001-F_Paste.gbr]
